mwyoung/Audio-Controlled-Switches/README.md

# Audio Controlled Switches

Oregon State University ECE Senior Project

By Jinshuai Gan (electrical work), Joseph Swelland (microphone, audio), and Miles Young (microcontroller, rx/tx, PCB).

Wifi code from Davide Gironi (GPLv3).

## Setup

The Hub folder contains code for the main controller with a microphone. The output folders
each control a specific output or PWM motor.

The PCB for each was identical, with the hub containing different parts than the output
devices.

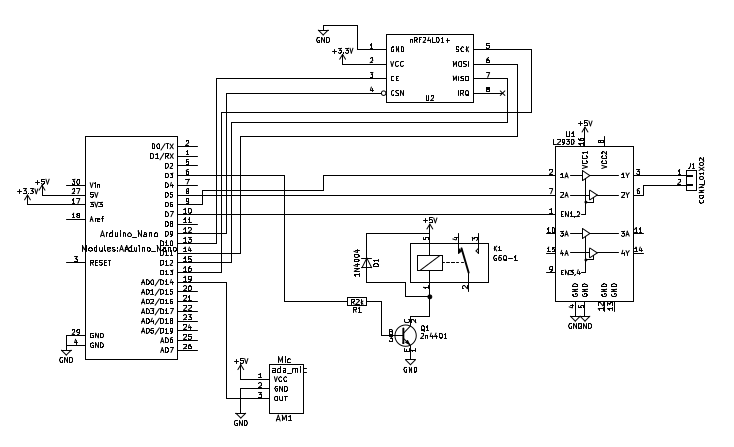
[picture p1: SchematicPCB/Schematic.png]
Schematic
