mwyoung/Audio-Controlled-Switches/SchematicPCB/schematic-rotated270.pdf

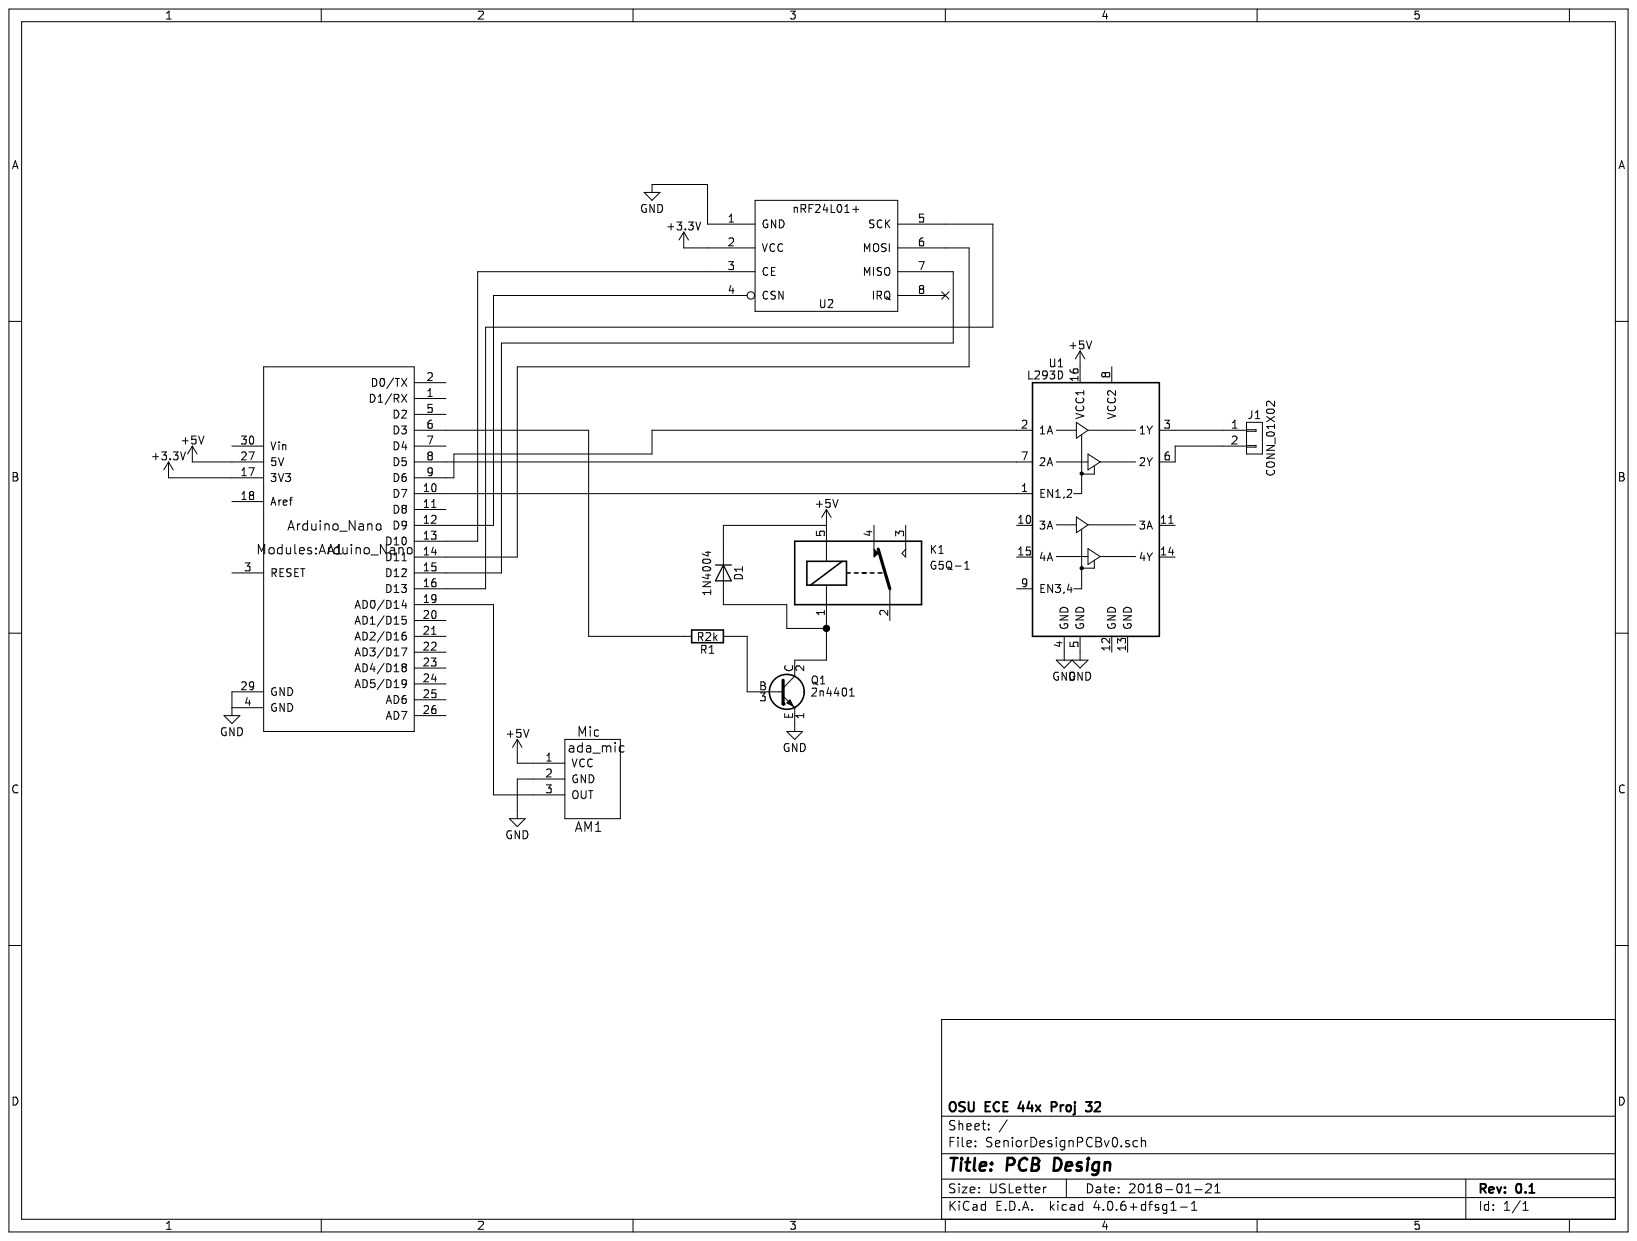
[picture p2: page 1]
