mwyoung/Audio-Controlled-Switches/SchematicPCB/SeniorDesignPCBv0.kicad_pcb

## KiCad design SchematicPCB/SeniorDesignPCBv0.kicad_pcb (2019-10-15)

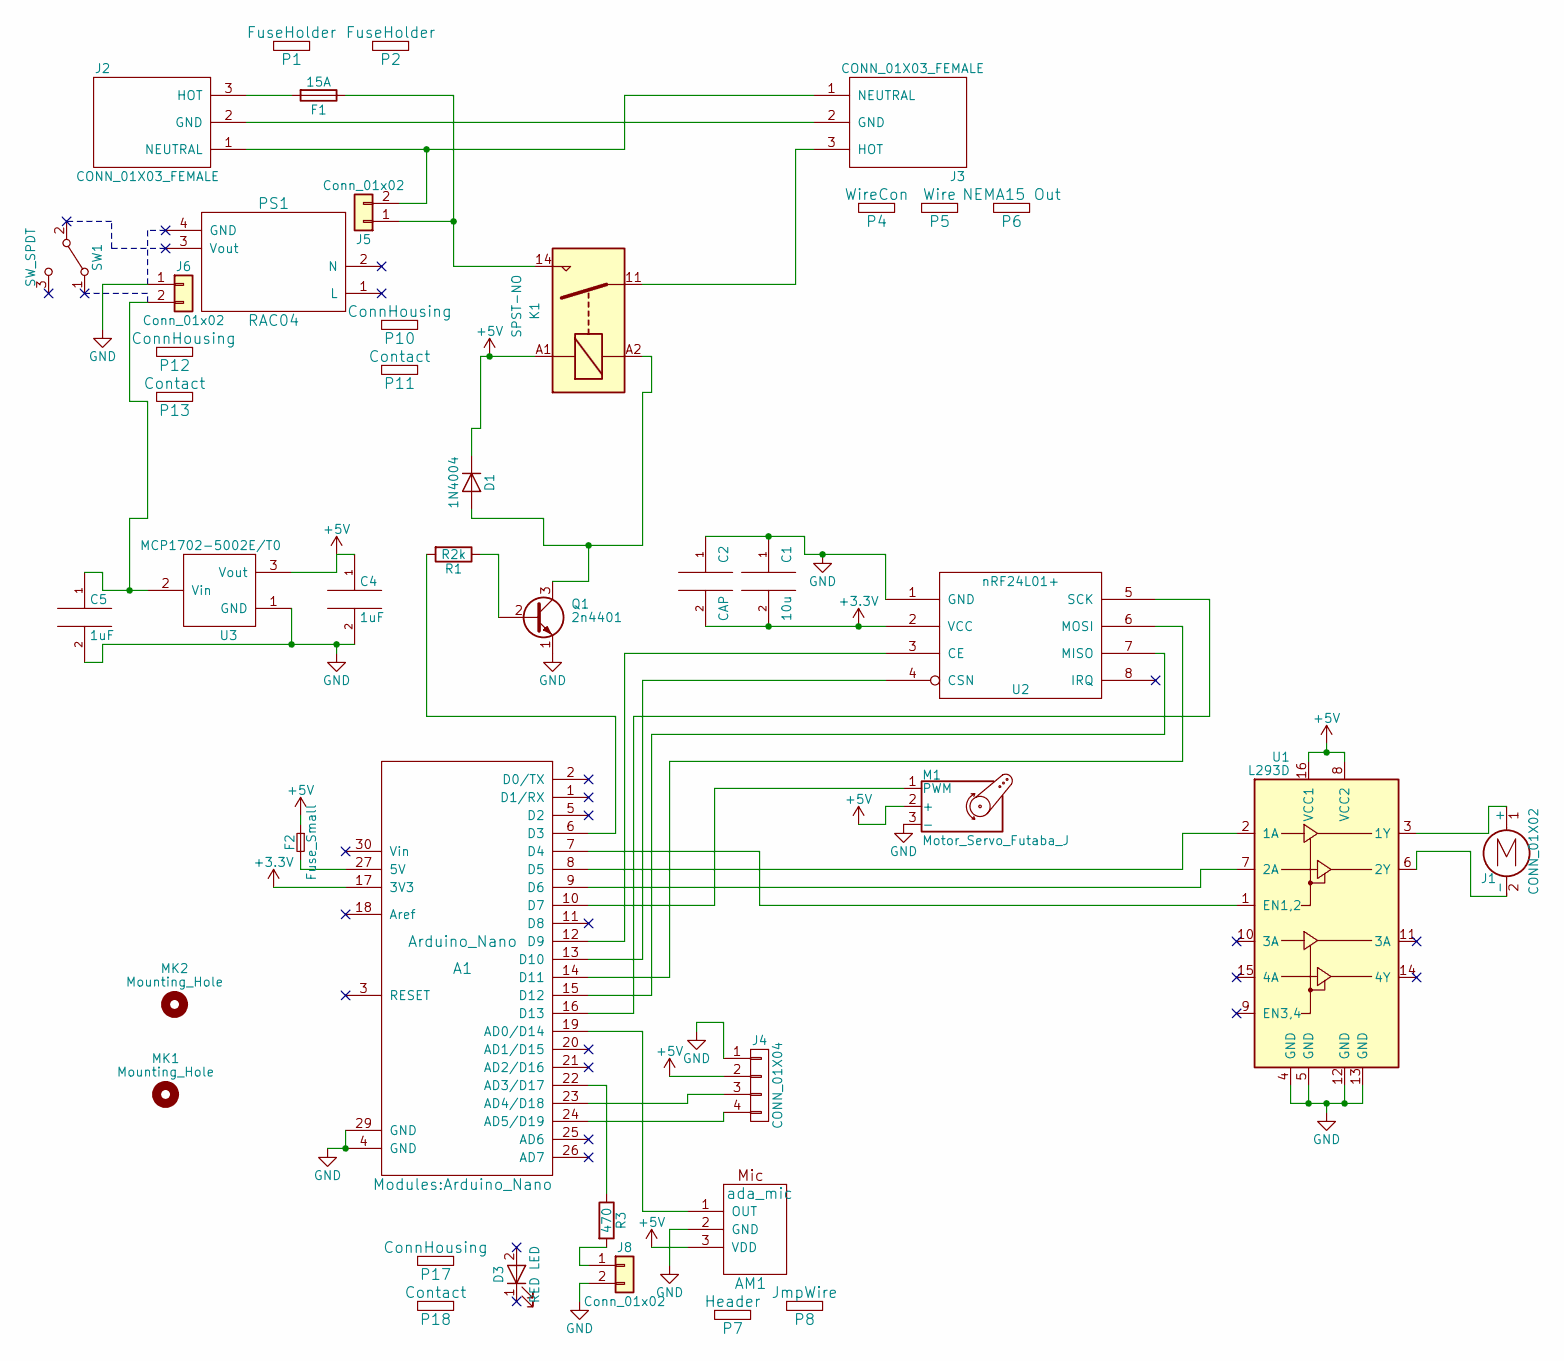
[picture p3: schematic SeniorDesignPCBv0.sch, PCB Design]

Parts:
A1: Arduino_Nano; Manufacturer Part # EL-CB-005
AM1: ada_mic; ADA_mic; Manufacturer Part # Adafruit MAX4466 Electret Mic Amplifier
C1: 10u; CP_Radial_D5.0mm_P2.00mm; Manufacturer Part # 860020472003
C2: CAP; C_Rect_L7.0mm_W2.5mm_P5.00mm; Manufacturer Part # K101K10X7RH5UH5
C4, C5: 1uF; CP_Radial_Tantal_D4.5mm_P2.50mm; Manufacturer Part # FG18X5R1H105KRT06
D1: 1N4004; D_A-405_P10.16mm_Horizontal; Manufacturer Part # 1N4004-TP
D3: RED LED; PlaceHolder; Manufacturer Part # C503B-RAN-CZ0C0AA1
F1: 15A; FuseHolder; Manufacturer Part # 3AG 15-R
F2: Fuse_Small; C_Disc_D8.0mm_W2.5mm_P5.00mm; Manufacturer Part # RXEF050
J1: CONN_01X02; Pin_Header_Straight_1x02_Pitch2.54mm; Manufacturer Part # SER0043
J2: CONN_01X03_FEMALE; 703W-1h; Manufacturer Part # 703W-00/53
J3: CONN_01X03_FEMALE; JST_VH_B3P-VH_3x3.96mm_Vertical; Manufacturer Part # B3P-VH(LF)(SN)
J4: CONN_01X04; Pin_Header_Straight_1x04_Pitch2.54mm; Manufacturer Part # M20-9990445
J5, J6, J8: Conn_01x02; JST_EH_B02B-EH-A_02x2.50mm_Straight; Manufacturer Part # B2B-EH-A(LF)(SN)
K1: SPST-NO; Relay_SPST_Schrack-RT1-16A-FormA_RM5mm; Manufacturer Part # RZ03-1A4-D005
M1: Motor_Servo_Futaba_J; Pin_Header_Straight_1x03_Pitch2.54mm; Manufacturer Part # 169
MK1, MK2: Mounting_Hole; MountingHole_3.5mm
P1, P2: FuseHolder; PlaceHolder; Manufacturer Part # FC-102-22
P4: WireCon; PlaceHolder; Manufacturer Part # VHR-3N
P5: Wire; PlaceHolder; Manufacturer Part # ASVHSVH16K152
P6: NEMA15 Out; PlaceHolder; Manufacturer Part # 738W-X2/03
P7: Header; PlaceHolder; Manufacturer Part # 61300311121
P8: JmpWire; PlaceHolder; Manufacturer Part # 1954
P10, P12, P17: ConnHousing; PlaceHolder; Manufacturer Part # EHR-2
P11, P13, P18: Contact; PlaceHolder; Manufacturer Part # SEH-001T-P0.6
PS1: RAC04; PlaceHolder; Manufacturer Part # RAC04-09SC/W
Q1: 2n4401; TO-92_Inline_Wide; Manufacturer Part # 2N4401BU
R1: R2k; R_Axial_DIN0204_L3.6mm_D1.6mm_P7.62mm_Horizontal; Manufacturer Part # CF14JT2K20
R3: 470; R_Axial_DIN0207_L6.3mm_D2.5mm_P10.16mm_Horizontal; Manufacturer Part # CF14JT470R
SW1: SW_SPDT; PlaceHolder; Manufacturer Part # 100SP1T2B4M6QE
U1: L293D; DIP-16_W7.62mm; Manufacturer Part # L239D
U2: nRF24L01+; NRF24L01; Manufacturer Part # BC22523
U3: MCP1702-5002E/T0; TO-92_Inline_Wide; Manufacturer Part # MCP1702-5002E/TO

Connections:
+3V3: A1.17 (3V3), C1.2, C2.2, U2.2 (VCC)
+5V: AM1.3 (VDD), C4.1, D1.1 (K), F2.1, J4.2, K1.A1, M1.2 (+), U1.8 (VCC2), U1.16 (VCC1), U3.3 (Vout)
GND: A1.4 (GND), A1.29 (GND), AM1.2 (GND), C1.1, C2.1, C4.2, C5.2, J4.1, J6.1, J8.2, M1.3 (-), Q1.1 (E), U1.4 (GND), U1.5 (GND), U1.12 (GND), U1.13 (GND), U2.1 (GND), U3.1 (GND)
unnamed: A1.6 (D3), R1.2
unnamed: A1.7 (D4), U1.1 (EN1,2)
unnamed: A1.8 (D5), U1.2 (1A)
unnamed: A1.9 (D6), U1.7 (2A)
unnamed: A1.10 (D7), M1.1 (PWM)
unnamed: A1.12 (D9), U2.3 (CE)
unnamed: A1.13 (D10), U2.4 (CSN)
unnamed: A1.14 (D11), U2.6 (MOSI)
unnamed: A1.15 (D12), U2.7 (MISO)
unnamed: A1.16 (D13), U2.5 (SCK)
unnamed: A1.19 (AD0/D14), AM1.1 (OUT)
unnamed: A1.22 (AD3/D17), R3.1
unnamed: A1.23 (AD4/D18), J4.3
unnamed: A1.24 (AD5/D19), J4.4
unnamed: A1.27 (5V), F2.2
unnamed: C5.1, J6.2, U3.2 (Vin)
unnamed: D1.2 (A), K1.A2, Q1.3 (C)
unnamed: F1.1, J5.1, K1.14
unnamed: F1.2, J2.3 (HOT)
unnamed: J1.1 (+), U1.3 (1Y)
unnamed: J1.2 (-), U1.6 (2Y)
unnamed: J2.1 (NEUTRAL), J3.1 (NEUTRAL), J5.2
unnamed: J2.2 (GND), J3.2 (GND)
unnamed: J3.3 (HOT), K1.11
unnamed: J8.1, R3.2
unnamed: Q1.2 (B), R1.1

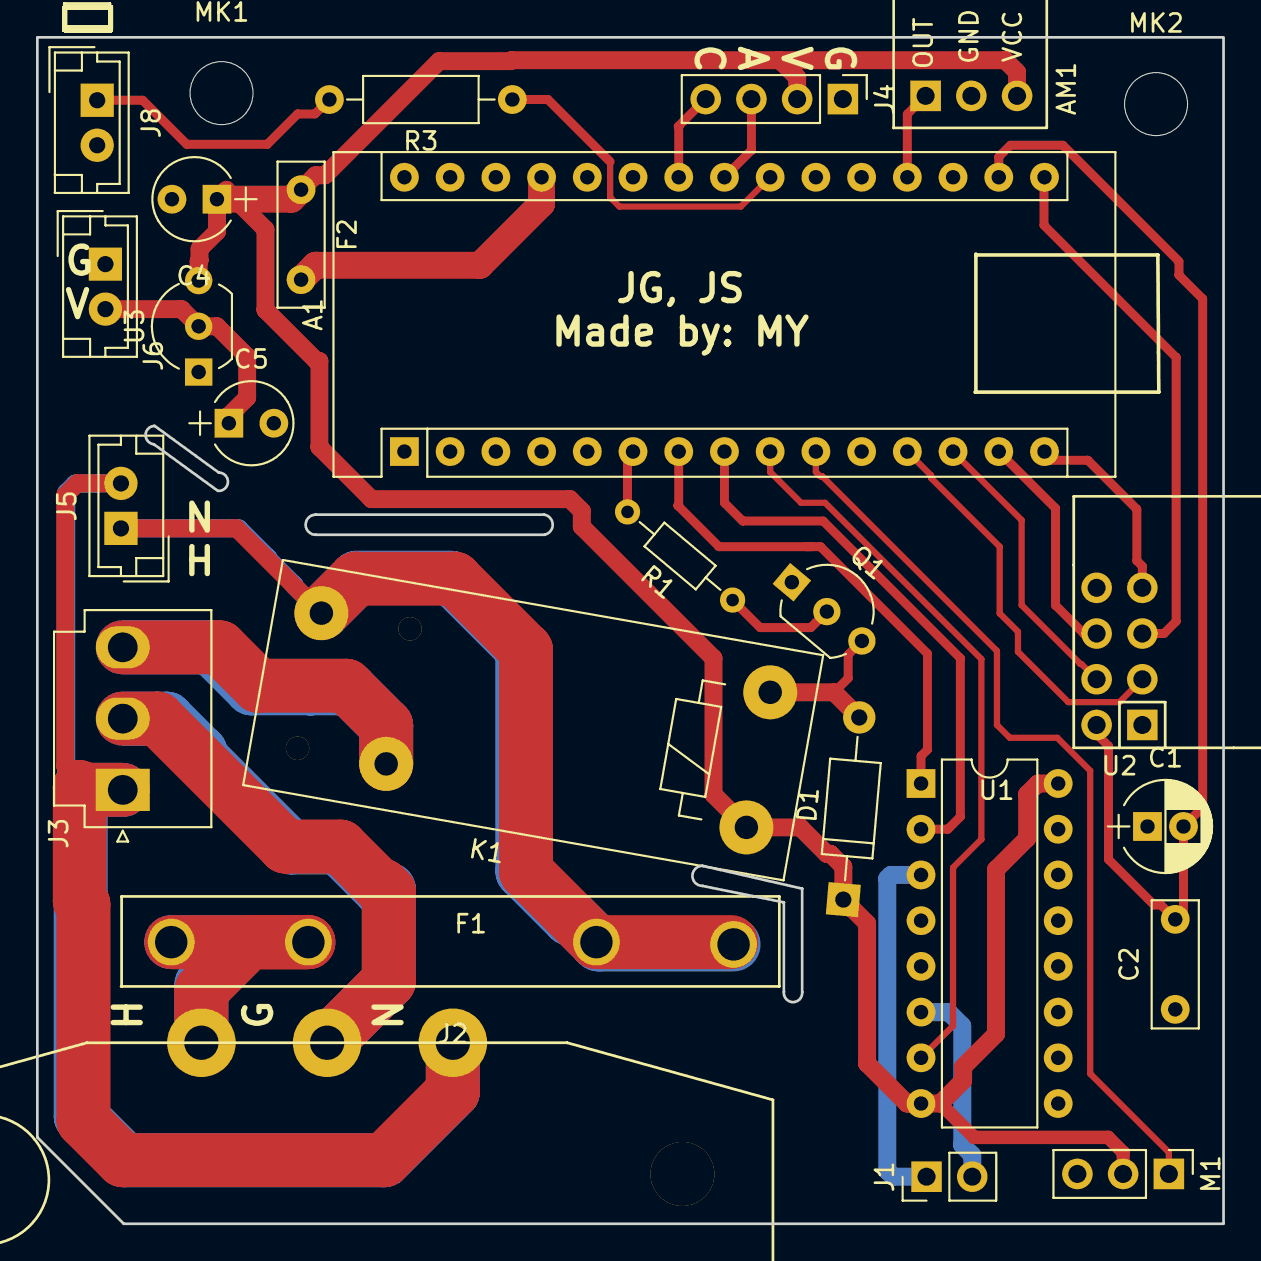
[picture p4: board SeniorDesignPCBv0.kicad_pcb from above]

Board: 2 copper layers, 65.9 x 65.9 mm, 42 parts (0 on the bottom side), 29 nets.
